teapotlaboratories/bwlr1f/hardware/main/kicad/production/TeapotLabsBWLR1F_Bottom.png

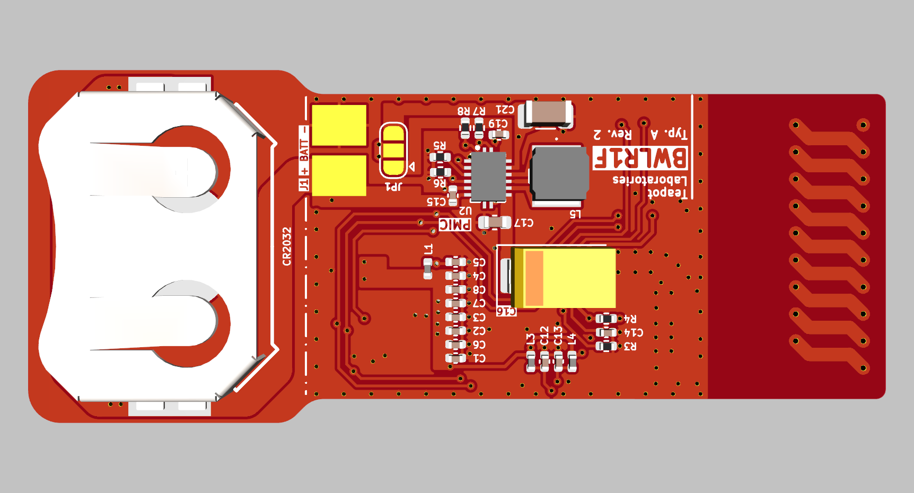
hardware/main/kicad/production/TeapotLabsBWLR1F_Bottom.png
