teapotlaboratories/bwlr1f/hardware/main/kicad/production/TeapotLabsBWLR1F_ImpedanceCalculation.png

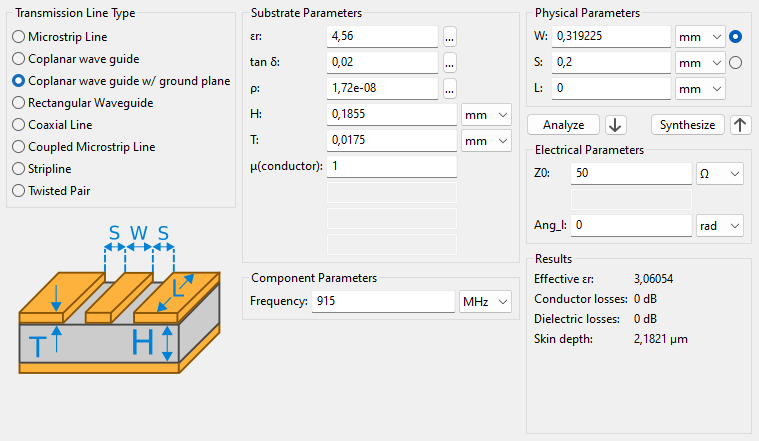
hardware/main/kicad/production/TeapotLabsBWLR1F_ImpedanceCalculation.png
