teapotlaboratories/bwlr1f/hardware/main/kicad/production/TeapotLabsBWLR1F_Top.png

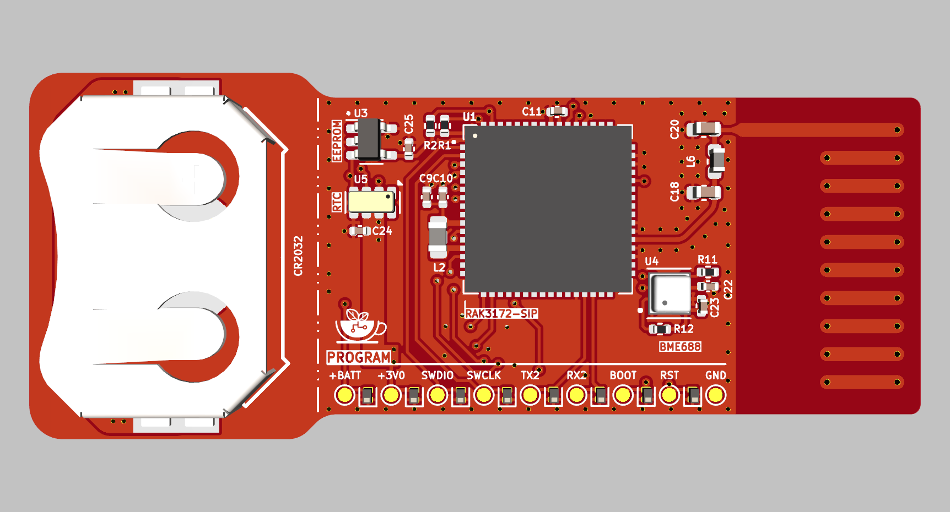
hardware/main/kicad/production/TeapotLabsBWLR1F_Top.png
