teapotlaboratories/bwlr1f/hardware/programmer/kicad/bwlr1f-prog.kicad_pcb

## KiCad design hardware/programmer/kicad/bwlr1f-prog.kicad_pcb (2024-08-28)

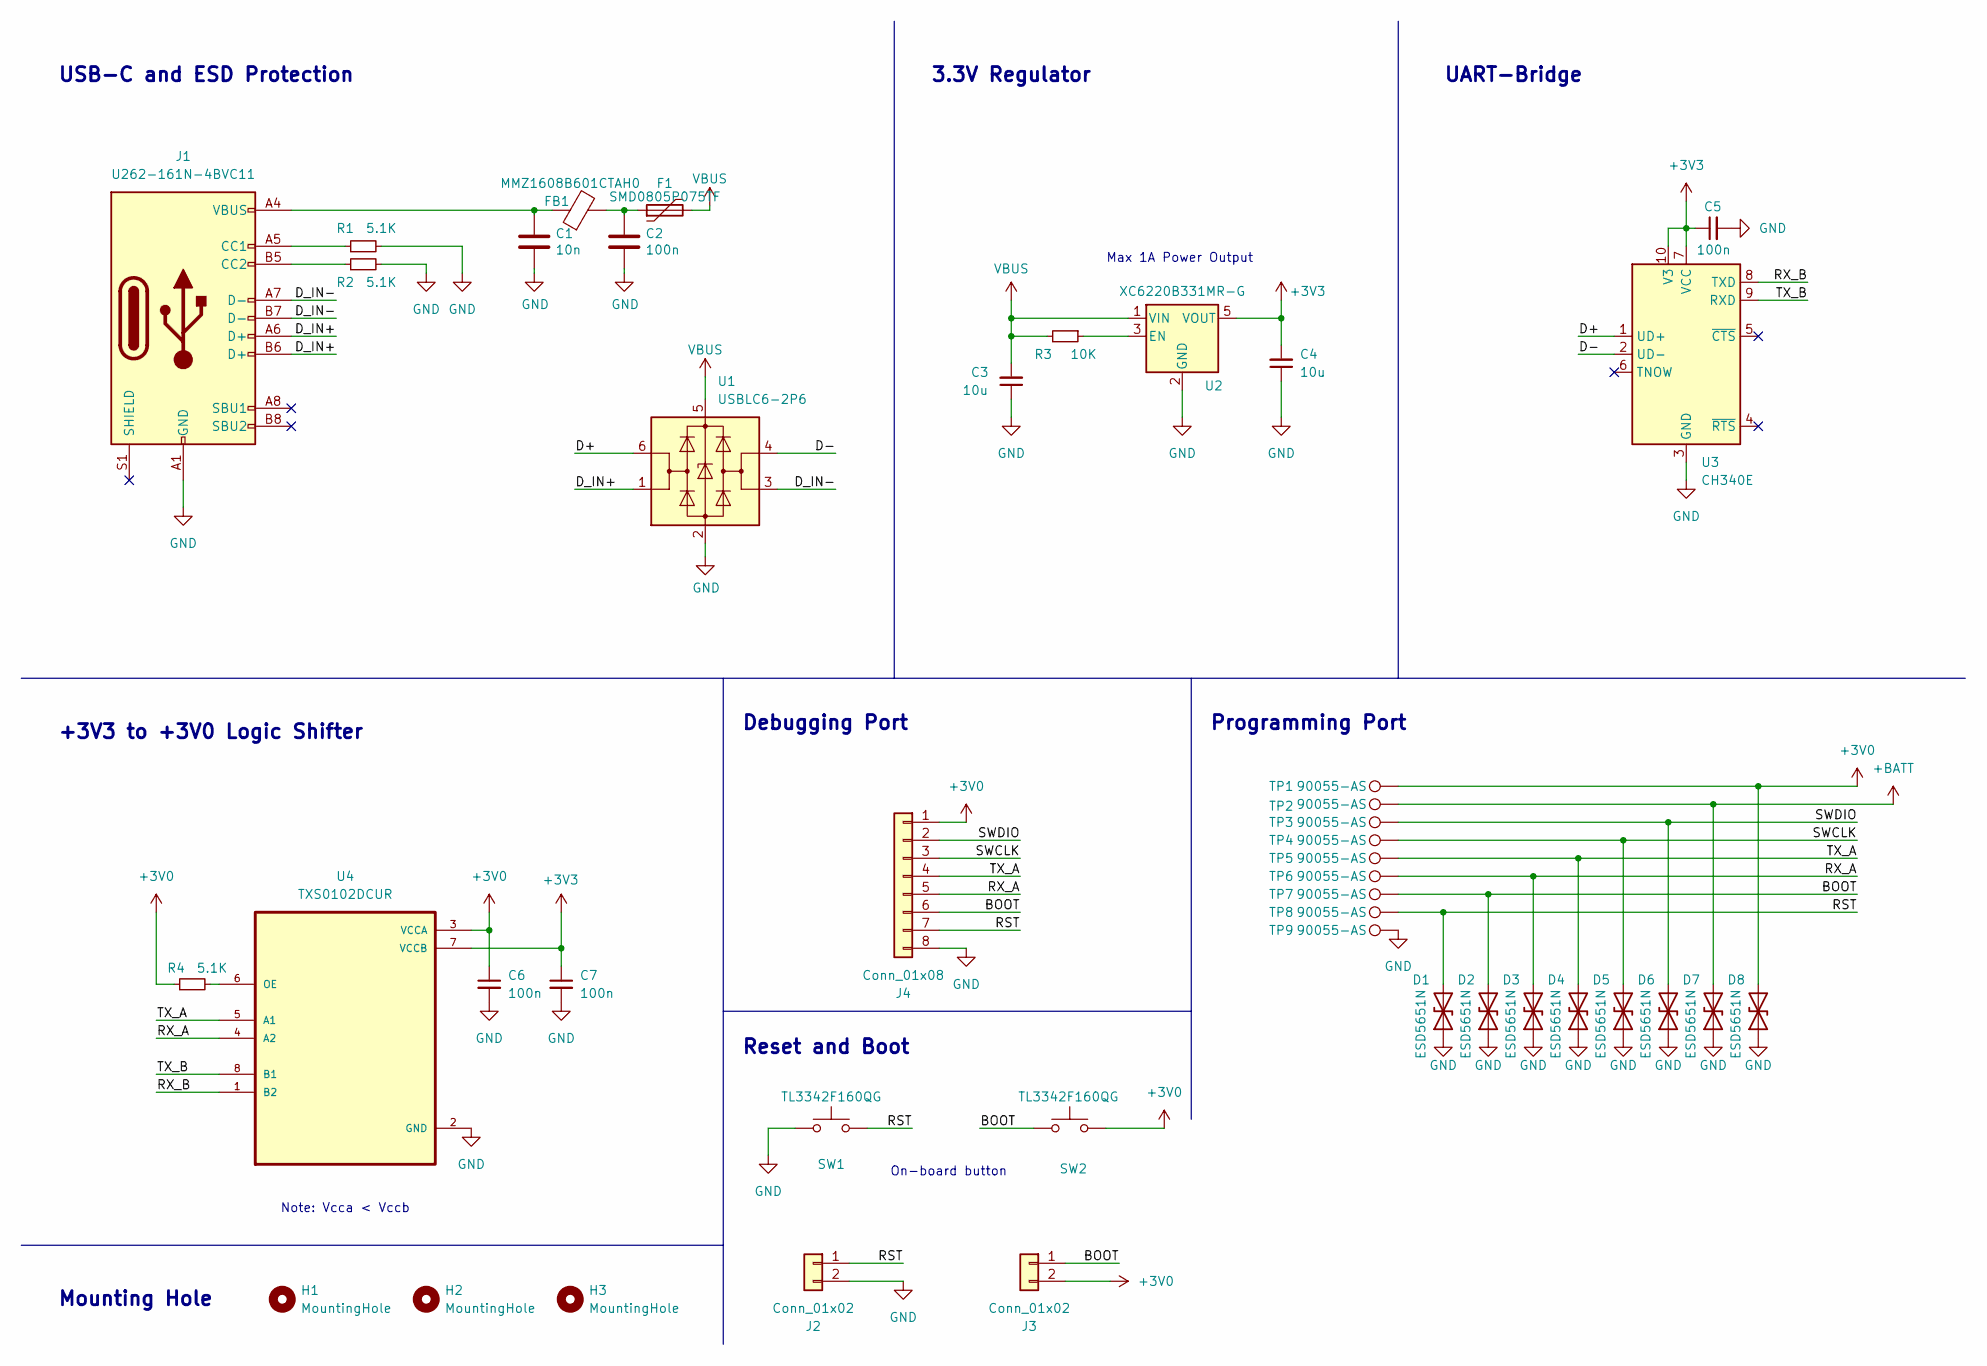
[picture p4: schematic bwlr1f-prog.kicad_sch]

Parts:
C1: 10n; C_0402_1005Metric; Part Number CC0402KRX7R9BB103
C2: 100n; C_0402_1005Metric; Part Number CC0402KRX5R6BB104
C3, C4: 10u; C_0805_2012Metric; Part Description Ceramic Capacitor 10uF 10% 10V X5R
C5: 100n; C_0603_1608Metric; Part Description Ceramic Capacitor 100nF 10% 10V X7R
C6, C7: 100n; C_0402_1005Metric; Manufacturer Part Number CL05B104KO5NNNC
D1, D2, D3, D4, D5, D6, D7, D8: ESD5651N; D_SOD-882; Manufacturer Part Number ESD5651N-2/TR
F1: SMD0805P075TF; Fuse_0805_2012Metric; Part Number SMD0805P075TF
FB1: MMZ1608B601CTAH0; L_0603_1608Metric; Part Number MMZ1608B601CTAH0
H1, H2, H3: MountingHole; MountingHole_2.2mm_M2_DIN965_Pad
J1: U262-161N-4BVC11; USB_C_Receptacle_XKB_U262-16XN-4BVC11; Part Number U262-161N-4BVC11
J2, J3: Conn_01x02; PinHeader_1x02_P2.54mm_Horizontal
J4: Conn_01x08; PinHeader_1x08_P2.54mm_Horizontal
R1, R2, R4: 5.1K; R_0402_1005Metric; Part Description Resistor 5.1K 1% 62.5mW
R3: 10K; R_0603_1608Metric; Part Description Resistor 10k 5% 100mW
SW1, SW2: TL3342F160QG; SW_SPST_TL3342; Part Number TL3342F160QG
TP1, TP2, TP3, TP4, TP5, TP6, TP7, TP8, TP9: 90055-AS; Manufacturer Part Number 90055-AS
U1: USBLC6-2P6; SOT-666; Part Number USBLC6-2P6
U2: XC6220B331MR-G; SOT-23-5; Part Number XC6220B331MR-G
U3: CH340E; MSOP-10_3x3mm_P0.5mm; Part Number CH340E
U4: TXS0102DCUR; SOP50P310X90-8N; Manufacturer Part Number TXS0102DCUR

Connections:
+3V0: C6.1, D8.2 (A2), J3.2, J4.1, R4.1, SW2.2, TP1.1, U4.3 (VCCA)
+3V3: C4.2, C5.1, C7.1, U2.5 (VOUT), U3.7 (VCC), U3.10 (V3), U4.7 (VCCB)
+BATT: D7.2 (A2), TP2.1
/BOOT: D2.2 (A2), J3.1, J4.6, SW2.1, TP7.1
/D+: U1.6 (I/O1), U3.1 (UD+)
/D-: U1.4 (I/O2), U3.2 (UD-)
/D_IN+: J1.A6 (D+), J1.B6 (D+), U1.1 (I/O1)
/D_IN-: J1.A7 (D-), J1.B7 (D-), U1.3 (I/O2)
/RST: D1.2 (A2), J2.1, J4.7, SW1.2, TP8.1
/RX_A: D3.2 (A2), J4.5, TP6.1, U4.4 (A2)
/RX_B: U3.8 (TXD), U4.1 (B2)
/SWCLK: D5.2 (A2), J4.3, TP4.1
/SWDIO: D6.2 (A2), J4.2, TP3.1
/TX_A: D4.2 (A2), J4.4, TP5.1, U4.5 (A1)
/TX_B: U3.9 (RXD), U4.8 (B1)
GND: C1.2, C2.2, C3.1, C4.1, C5.2, C6.2, C7.2, D1.1 (A1), D2.1 (A1), D3.1 (A1), D4.1 (A1), D5.1 (A1), D6.1 (A1), D7.1 (A1), D8.1 (A1), J1.A1 (GND), J1.A12 (GND), J1.B1 (GND), J1.B12 (GND), J2.2, J4.8, R1.2, R2.2, SW1.1, TP9.1, U1.2 (GND), U2.2 (GND), U3.3 (GND), U4.2 (GND)
unnamed: C1.1, FB1.1, J1.A4 (VBUS), J1.A9 (VBUS), J1.B4 (VBUS), J1.B9 (VBUS)
unnamed: C2.1, F1.1, FB1.2
unnamed: J1.A5 (CC1), R1.1
unnamed: J1.B5 (CC2), R2.1
unnamed: R3.1, U2.3 (EN)
unnamed: R4.2, U4.6 (OE)
VBUS: C3.2, F1.2, R3.2, U1.5 (VBUS), U2.1 (VIN)

Notes on the sheet:
Debugging Port
Mounting Hole
UART-Bridge
Max 1A Power Output
Note: Vcca < Vccb
Programming Port
USB-C and ESD Protection
On-board button
Reset and Boot
+3V3 to +3V0 Logic Shifter
3.3V Regulator

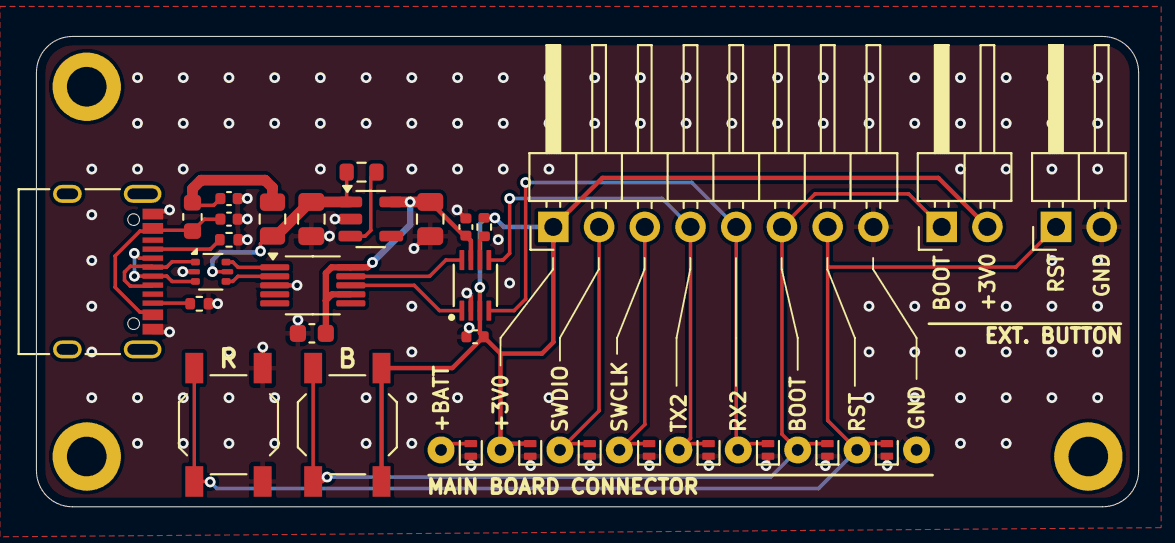
[picture p5: board bwlr1f-prog.kicad_pcb from above]

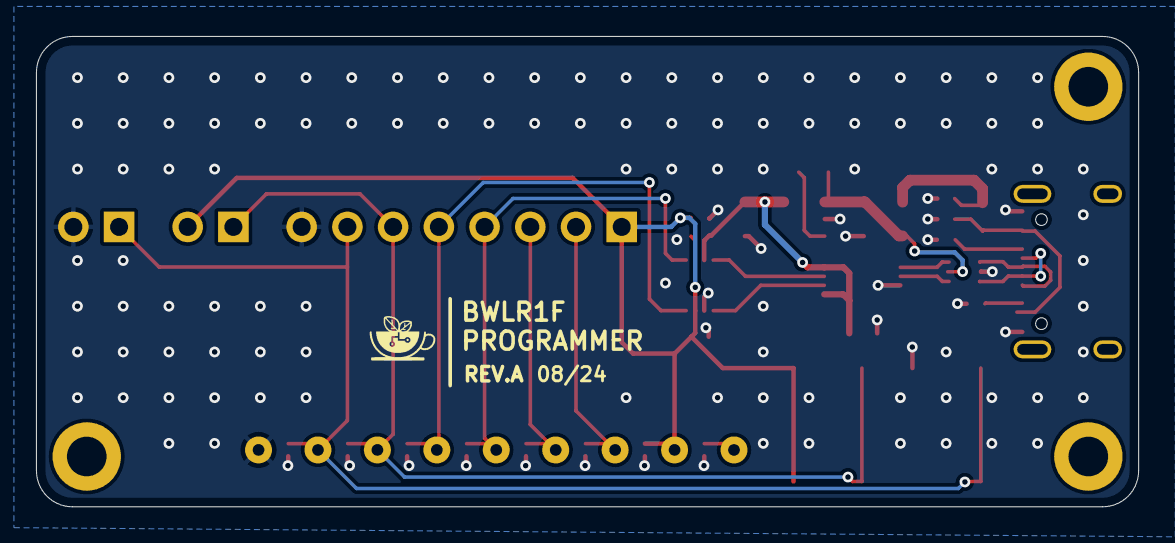
[picture p6: board bwlr1f-prog.kicad_pcb from below]

Board: 2 copper layers, 61.2 x 26.1 mm, 43 parts (9 on the bottom side), 23 nets.
