teapotlaboratories/bwlr1f/hardware/main/kicad/bwlr1f.kicad_pcb

## KiCad design hardware/main/kicad/bwlr1f.kicad_pcb (2024-08-28)

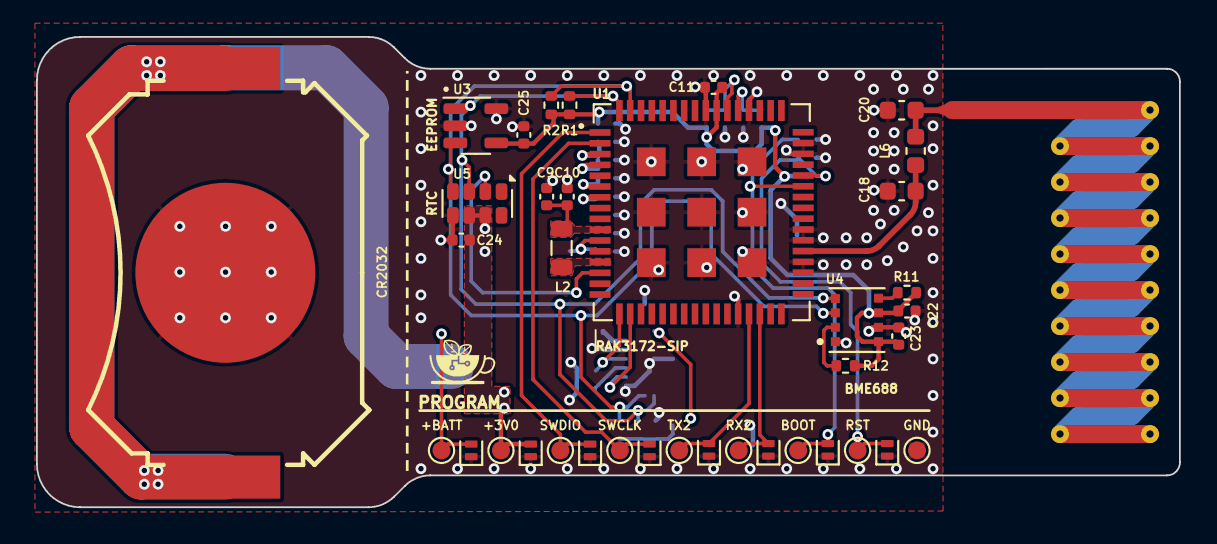
[picture p7: board bwlr1f.kicad_pcb from above]

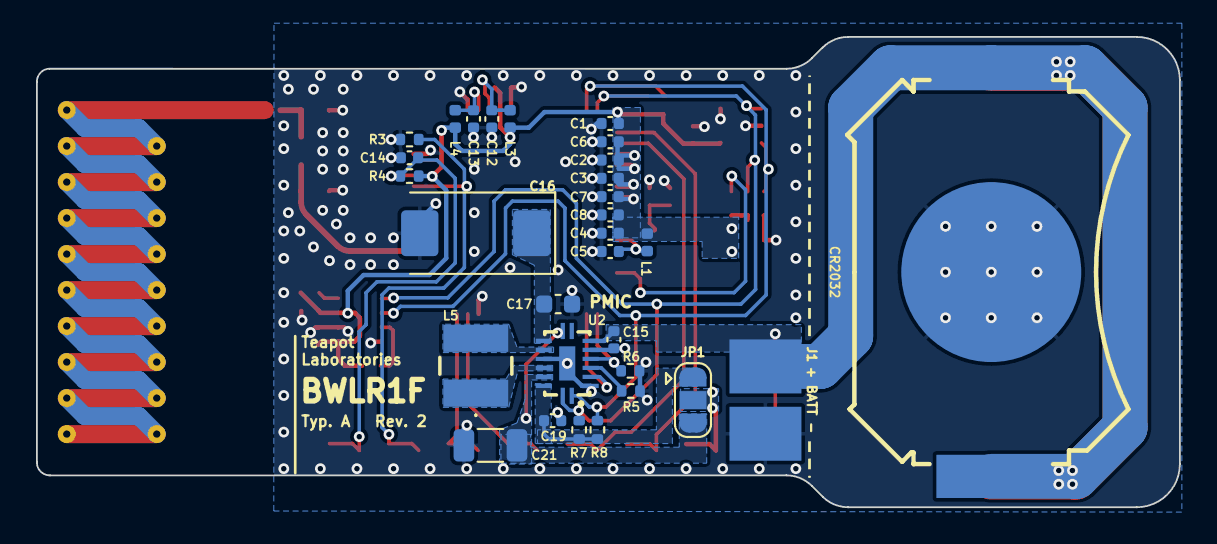
[picture p8: board bwlr1f.kicad_pcb from below]

Board: 4 copper layers, 63.5 x 26.1 mm, 68 parts (30 on the bottom side), 29 nets.

Parts:
AE1: Antenna; Texas_SWRA416_868MHz_915MHz
BT1, BT2: Battery_Cell; BAT-SMD_MY-2032-12
C1, C3, C4: 4u7; C_0402_1005Metric
C2, C12, C13, C15, C19, C25: 1u; C_0402_1005Metric
C5, C6, C7, C8, C10, C11, C14, C22, C23, C24: 100n; C_0402_1005Metric
C9: 470n; C_0402_1005Metric
C16: 470u; CP_EIA-7343-40_Kemet-Y
C17: 10u; C_0603_1608Metric
C18, C20: DNP; C_0603_1608Metric
C21: 22u; C_1206_3216Metric
D1, D2, D3, D4, D5, D6, D7, D8: ESD5651N; D_SOD-882
J1: Conn_01x02; Battery_Pad
JP1: OUTPUT_SELECT; SolderJumper-3_P1.3mm_Open_RoundedPad1.0x1.5mm
L1, L3, L4: 120; L_0402_1005Metric
L2: 15u; L_0805_2012Metric
L5: 15u; 74404042150
L6: 0; L_0603_1608Metric
R1, R2: 4K7; R_0402_1005Metric
R3, R4, R11, R12: 10K; R_0402_1005Metric
R5, R6: 100K; R_0402_1005Metric
R7, R8: 1K; R_0402_1005Metric
TP1, TP2, TP3, TP4, TP5, TP6, TP7, TP8, TP9: ProgPin; TestPoint_Pad_D1.0mm
U1: RAK3172-SIP; RAK3172-SiP_LGA75
U2: NBM7100ABQX
U3: ZD24C08A; SOT-23-5
U4: BME688; BME680-PSON80P300X300X100-8N
U5: RV-3028-C7; MicroCrystal_C7_SON-8_1.5x3.2mm_P0.9mm

Connections:
+3V0: C1.2, C2.2, C3.2, C4.2, C6.2, C7.2, C8.2, C11.2, C22.2, C23.2, C24.2, C25.2, D8.2 (A2), JP1.2 (C), L1.1, L3.2, L4.2, R1.1, R2.1, R4.1, R11.1, R12.1, TP1.1, U1.3 (VDD), U1.4 (VBAT), U1.6 (VREF+), U1.7 (VDDA), U1.55 (VDD), U3.4 (VCC), U4.6 (VDDIO), U4.8 (VDD), U5.6 (VBACKUP), U5.7 (VDD)
/+VDP: C19.2, JP1.1 (A), R7.1, R8.1, U2.15 (VDP)
/ANT: AE1.1 (A), C20.2, L6.2
/BATT+: BT1.1 (+), BT2.1 (+), C15.2, D7.2 (A2), J1.1, TP2.1, U2.7 (VBT)
/BOOT: D1.2 (A2), R3.1, TP8.1, U1.43 (BOOT_0)
/RDY: U1.18 (PB7/UART1_RX), U2.3 (RDY)
/RF: C18.2, L6.1, U1.37 (RF_OUT)
/RST: C14.2, D2.2 (A2), R4.2, TP7.1, U1.44 (NRST)
/RTC_WKUP: U1.14 (PB3), U5.2 (~INT)
/RX2: D6.2 (A2), TP3.1, U1.30 (PA3/UART2_RX)
/SCL: R1.2, R7.2, U1.64 (PA12/I2C2_SCL), U2.16 (SCL), U3.1 (SCL), U4.4 (SCK), U5.3 (SCL)
/SDA: R2.2, R8.2, U1.63 (PA11/I2C2_SDA), U2.1 (SDA), U3.3 (SDA), U4.3 (SDI), U5.4 (SDA)
/START: R6.1, U1.17 (PB6/UART1_TX), U2.5 (START)
/SWCLK: D4.2 (A2), TP5.1, U1.2 (PA14/SWCLK)
/SWDIO: D3.2 (A2), TP6.1, U1.1 (PA13/SWDIO)
/TX2: D5.2 (A2), TP4.1, U1.29 (PA2/UART2_TX)
GND: BT1.2 (-), BT2.2 (-), C1.1, C2.1, C3.1, C4.1, C5.1, C6.1, C7.1, C8.1, C9.1, C10.1, C11.1, C12.1, C13.1, C14.1, C15.1, C16.2, C17.1, C18.1, C19.1, C20.1, C21.1, C22.1, C23.1, C24.1, C25.1, D1.1 (A1), D2.1 (A1), D3.1 (A1), D4.1 (A1), D5.1 (A1), D6.1 (A1), D7.1 (A1), D8.1 (A1), J1.2, R3.2, R5.2, R6.2, TP9.1, U1.12 (GND), U1.28 (GND), U1.35 (GND), U1.36 (GND), U1.38 (GND), U1.39 (GND), U1.46 (GND), U1.47 (GND), U1.52 (GND), U1.56 (GND), U1.65 (GND), U1.66 (GND), U1.67 (GND), U1.68 (GND), U1.69 (GND), U1.70 (GND), U1.71 (GND), U1.72 (GND), U1.73 (GND), U2.2 (TST), U2.6 (VSS_1), U2.12 (VSSP), U2.17 (VSS_2), U3.2 (VSS), U3.5 (WP), U4.1 (GND), U4.7 (GND), U5.5 (VSS)
unnamed: C21.2, JP1.3 (B), U2.9 (VDHS), U2.14 (VDH)
unnamed: C5.2, L1.2, U1.11 (VDDMPS)
unnamed: C13.2, L4.1, U1.53 (VDDPA)
unnamed: C12.2, L3.1, U1.54 (VDDRF)
unnamed: C9.2, C10.2, L2.1, U1.10 (VFBSMPS)
unnamed: L2.2, U1.13 (VLXSMPS)
unnamed: R5.1, U2.4 (ADR)
unnamed: C16.1, C17.2, U2.10 (CAP)
unnamed: L5.1, U2.13 (LX1)
unnamed: L5.2, U2.11 (LX2)
unnamed: R12.2, U4.2 (CSB)
unnamed: R11.2, U4.5 (SDO)
