teapotlaboratories/bwlr1f/(commit log)

2023-12-02 initial file
    [bwlr1f.kicad_pcb, bwlr1f.kicad_sch]
2023-12-16 add notes
    [bwlr1f.kicad_sch]
2023-12-16 generate bom & cpl
    [bwlr1f_BOM.csv]
2023-12-23 finish bom & cpl
    [bwlr1f.kicad_sch, bwlr1f_BOM.csv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]
2024-01-08 add mosfet switch for M_DRV
    [bwlr1f.kicad_sch]
2024-01-08 wip: re-route layout
    [bwlr1f.kicad_pcb]
2024-01-09 wip: re-layout
    [bwlr1f.kicad_pcb, bwlr1f.kicad_sch]
2024-01-09 wip: initial pcb prod
    [bwlr1f.kicad_pcb, bwlr1f.kicad_sch]
2024-01-09 add battery cr2302 holder
2024-01-09 add battery pack
    [bwlr1f.kicad_pcb, bwlr1f.kicad_sch]
2024-01-10 first production file revision 1
    [TeapotlabsBWLR1F_BOM.csv, bwlr1f.kicad_pcb, bwlr1f.kicad_sch, bwlr1f_BOM.csv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]
2024-01-10 remove break away tabs
    [bwlr1f.kicad_pcb]
2024-01-10 fix In2 ground
    [bwlr1f.kicad_pcb]
2024-01-11 fix wrong qty for Q1 and Q1
    [TeapotlabsBWLR1F_BOM.csv]
2024-01-26 change antenna
    [bwlr1f.kicad_pcb, bwlr1f.kicad_sch]
2024-01-26 update layout
    [bwlr1f.kicad_pcb, bwlr1f.kicad_sch]
2024-01-30 Revert "update layout"
    This reverts commit 7d4c2235c3ae4d9f911583b993bcb32887b0ae1e.
    [bwlr1f.kicad_pcb, bwlr1f.kicad_sch]
2024-01-30 Revert "change antenna"
    This reverts commit 46c20b2a2dd1e0a5efdce99ceacd3ab7d772dc0d.
    [bwlr1f.kicad_pcb, bwlr1f.kicad_sch]
2024-01-30 add initial mdrv latcher circuit
    [bwlr1f.kicad_sch]
2024-07-31 bwlr1f update
    [bwlr1f.kicad_pcb, bwlr1f.kicad_sch]
2024-08-03 Add programmer file
    [TeapotlabsBWLR1F_BOM.csv, bwlr1f-prog.kicad_pcb, bwlr1f-prog.kicad_sch, bwlr1f.kicad_pcb, bwlr1f.kicad_sch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]
2024-08-05 Update Programmer
    [bwlr1f-prog.kicad_pcb, bwlr1f-prog.kicad_sch, bwlr1f.kicad_pcb, bwlr1f.kicad_sch]
2024-08-06 Added ESD to main board
    [bwlr1f-prog.kicad_pcb, bwlr1f.kicad_pcb, bwlr1f.kicad_sch]
2024-08-06 Update PCB layout
    [bwlr1f-prog.kicad_pcb, bwlr1f-prog.kicad_sch]
2024-08-12 Update for Programmer
    [bwlr1f-prog.kicad_pcb, bwlr1f-prog.kicad_sch, bwlr1f.kicad_pcb]
2024-08-13 Finish Production File for Main Board
    [TeapotLabsBWLR1F_BOM.xlsx, bwlr1f.kicad_pcb, bwlr1f.kicad_sch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]
2024-08-13 Finish Production File for Programmer Board
    [TeapotLabsBWLR1F-Prog_BOM.xlsx, bwlr1f-prog.kicad_pcb, bwlr1f-prog.kicad_sch, bwlr1f.kicad_pcb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]
2024-08-13 Update for Main Board
    [bwlr1f.kicad_pcb]
2024-08-22 Change PCB Antenna
    [bwlr1f.kicad_pcb, bwlr1f.kicad_sch]
2024-08-22 Main Board Revision
    [bwlr1f.kicad_pcb]
2024-08-22 Revert "Main Board Revision"
    This reverts commit c5b913284f91f81721d22b196ba55e4d9f276ba3.
    [bwlr1f.kicad_pcb]
2024-08-26 Revision finish, update production file
    [TeapotLabsBWLR1F_BOM.xlsx, bwlr1f-prog.kicad_pcb, bwlr1f.kicad_pcb, bwlr1f.kicad_sch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]
2024-08-28 Revert "Change PCB Antenna"
    This reverts commit 5ca8b7b7452485b6d3384e8d9324ab527cbc9679.
    [bwlr1f.kicad_pcb, bwlr1f.kicad_sch]
2024-08-28 update silkscreen rev identifier
    [bwlr1f.kicad_pcb]
2024-08-28 update sheets info
    [bwlr1f.kicad_pcb, bwlr1f.kicad_sch]
